kesmart/AloeVera/AloeVera/AloeVera.ino

/*********
  WEB Server template credit: Rui Santos
  Complete project details at https://randomnerdtutorials.com
*********/

// Load Wi-Fi library
#include <WiFi.h>

// Replace with your network credentials
const char* ssid = "TELUS3064";
const char* password = "qy87j9jn5f";

// Set web server port number to 80
WiFiServer server(80);

// Variable to store the HTTP request
String header;

// Auxiliar variables to store the current output state
String pumpState = "off";
int soilMoisture;
const int waterTime = 2000;
const int drySoil = 3000;

// Assign output variables to GPIO pins
const int pumpPin = 26;
const int soilPin = 34;
const int grPin = 32;
const int rPin = 33;

// For timer when the client is connected
unsigned long grLedStartTime = 0;
bool grLedActive = false;
 
unsigned long currentTime = millis();
unsigned long previousTime = 0;
const long timeoutTime = 2000;

void setup() {
    Serial.begin(115200);
    // Initialize the output variables as outputs
    pinMode(pumpPin, OUTPUT);
    pinMode(soilPin, INPUT);
    pinMode(grPin, OUTPUT);
    pinMode(rPin, OUTPUT);
    // Set outputs to LOW
    digitalWrite(pumpPin, LOW);
    soilMoisture = analogRead(soilPin);
    digitalWrite(grPin, LOW);
    digitalWrite(rPin, LOW);
    Serial.println("lights on"); 

    // Connect to Wi-Fi network with SSID and password
    Serial.print("Connecting to ");
    Serial.println(ssid);
    WiFi.begin(ssid, password);
    while (WiFi.status() != WL_CONNECTED) {
        delay(500);
        Serial.print(".");
    }
    // Print local IP address and start web server
    Serial.println("");
    Serial.println("WiFi connected.");
    Serial.println("IP address: ");
    Serial.println(WiFi.localIP());
    server.begin();
}

void loop() {
    if (grLedActive && (millis() - grLedStartTime >= 120000UL)) {
      digitalWrite(grPin, LOW);
      digitalWrite(rPin, LOW);
      grLedActive = false;
    }

    WiFiClient client = server.available();   // Listen for incoming clients

    if (client) {                             // If a new client connects,
        currentTime = millis();
        previousTime = currentTime;
        Serial.println("New Client.");          // print a message out in the serial port

        // Client connected timer (2mins)
        digitalWrite(grPin, HIGH);
        grLedStartTime = millis();  // Start the 2-minute timer
        grLedActive = true;         // Arm the auto-off

        String currentLine = "";                // make a String to hold incoming data from the client
        while (client.connected() && currentTime - previousTime <= timeoutTime) {  // loop while the client's connected
            currentTime = millis();
            if (client.available()) {             // if there's bytes to read from the client,
                char c = client.read();             // read a byte, then
                Serial.write(c);                    // print it out the serial monitor
                header += c;
                if (c == '\n') {                    // if the byte is a newline character
                    // if the current line is blank, you got two newline characters in a row.
                    // that's the end of the client HTTP request, so send a response:
                    if (currentLine.length() == 0) {
                        // HTTP headers always start with a response code (e.g. HTTP/1.1 200 OK)
                        // and a content-type so the client knows what's coming, then a blank line:
                        client.println("HTTP/1.1 200 OK");
                        client.println("Content-type:text/html");
                        client.println("Connection: close");
                        client.println();

                        // Display the HTML web page
                        client.println("<!DOCTYPE html><html>");
                        // Header block
                        if (header.indexOf("GET /pump/start") >= 0) {
                            pumpState = "on";
                            // Only add the refresh when watering
                            client.println("<head><meta name=\"viewport\" content=\"width=device-width, initial-scale=1\">");
                            client.println("<meta http-equiv=\"refresh\" content=\"" + String(waterTime / 1000) + "; url=/\">");
                            client.println("</head>");
                        }
                        else {
                            // Normal head without refresh
                            client.println("<head><meta name=\"viewport\" content=\"width=device-width, initial-scale=1\">");
                            client.println("</head>");
                        }

                        client.println("<link rel=\"icon\" href=\"data:,\">");
                        // CSS to style the on/off buttons 
                        // Feel free to change the background-color and font-size attributes to fit your preferences
                        client.println("<style>html { font-family: Helvetica; display: inline-block; margin: 0px auto; text-align: center;}");
                        client.println(".button { background-color: #4CAF50; border: none; color: white; padding: 16px 40px;");
                        client.println("text-decoration: none; font-size: 30px; margin: 2px; cursor: pointer;}");
                        client.println(".button2 {background-color: #555555;}</style></head>");

                        // Web Page Heading
                        client.println("<body><h1>Aloe Vera</h1>");

                        // Display current state, and ON/OFF buttons for GPIO 26
                        soilMoisture = analogRead(soilPin);
                        if (soilMoisture > drySoil){
                          digitalWrite(rPin, HIGH);
                        }
                        else {
                          digitalWrite(rPin, LOW);
                        }
                        client.println("<p>Soil Moisture Level = " + String(soilMoisture) + "</p>");
                        if (header.indexOf("GET /test/moisture") >= 0) {
                            client.println("<p><a href=\"/test/moisture\"><button class=\"button\">Test Soil</button></a></p>");
                            client.println("</body></html>");

                            client.println("<head><meta name=\"viewport\" content=\"width=device-width, initial-scale=1\">");
                            client.println("<meta http-equiv=\"refresh\" content=\"" + String(0) + "; url=/\">");
                            client.println("</head>");
                        }
                        else {
                            client.println("<p><a href=\"/test/moisture\"><button class=\"button\">Test Soil</button></a></p>");
                        }


                        client.println("<p>Pump " + pumpState + "</p>");
                        // turns the GPIOs on and off
                        if (header.indexOf("GET /pump/start") >= 0) {
                            Serial.println("GPIO 26 on");
                            pumpState = "on";
                            client.println("<p><a href=\"/pump/start\"><button class=\"button button2\">Watering...</button></a></p>");
                            client.println("</body></html>");
                            client.println();
                            client.stop();

                            digitalWrite(pumpPin, HIGH);
                            delay(waterTime);
                            pumpState = "off";
                            digitalWrite(pumpPin, LOW);
                            header = "";
                        }
                        else {
                            client.println("<p><a href=\"/pump/start\"><button class=\"button\">WATER</button></a></p>");
                        }

                        client.println("</body></html>");
                        client.println();

                        break;
                    }
                    else { // if you got a newline, then clear currentLine
                        currentLine = "";
                    }
                }
                else if (c != '\r') {  // if you got anything else but a carriage return character,
                    currentLine += c;      // add it to the end of the currentLine
                }
            }
        }
        // Clear the header variable
        header = "";
        // Close the connection
        client.stop();
        Serial.println("");
    }
}
