kesmart/AloeVera/(commit log)

2026-02-25 Update AloeVera.ino
    - Edit web server to have a single water button that waters the plant for some amount of time
    - Added a page refresh so the button changes to "watering..." while the pump is going
2026-03-10 Rearranging files
    - Move file locations
    - Add LEDs pins
2026-03-10 Update AloeVera.ino
    Set green and red LED pin modes to output
2026-03-10 Create LEDdebug.ino
    Debugging code for the electronics and LEDs
2026-03-12 Update AloeVera.ino
    - Updating variables
    - Fixing LED behaviours
    [AloeVera.ino]
2026-03-12 KiCAD files
    Made KiCAD project for future PCB
    [AloeVeraPCB.kicad_pcb, AloeVeraPCB.kicad_sch]
